WKTodd/AnaloguePPM/readme.md

Analogue Peak Meter using 101 segment Vacuum Flourescent Display module.

Uses a Microchip PIC 12F1572 (MPASM) and simple hardware
