WKTodd/AnaloguePPM/Hardware/VDF Meter Case base.STL

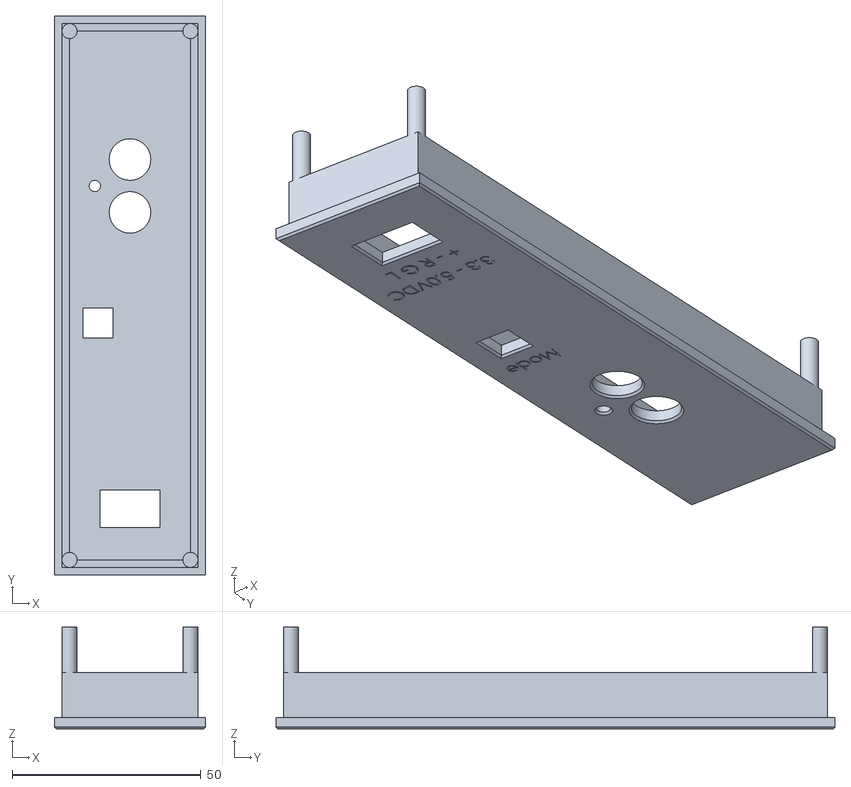
[picture p1: CAD file, 2021-10-20]
Hardware/VDF Meter Case base.STL
40.0 x 148.0 x 27.0
