WKTodd/AnaloguePPM/Hardware/VDF Meter Case.STL

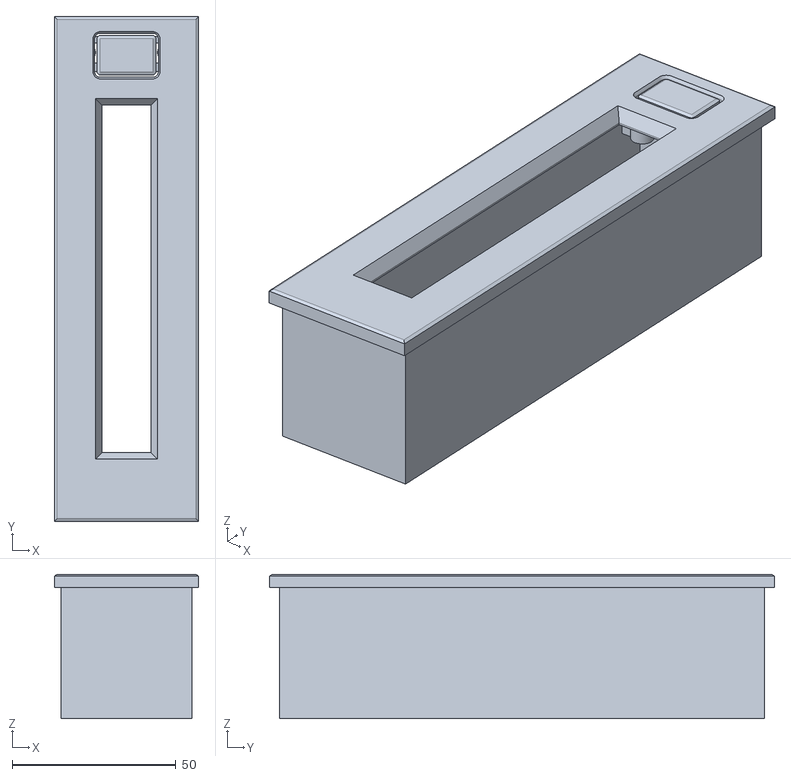
[picture p2: CAD file, 2021-10-20]
Hardware/VDF Meter Case.STL
44.0 x 154.0 x 44.0
