WKTodd/AnaloguePPM/ADT Analogue Peak Meter.pdf

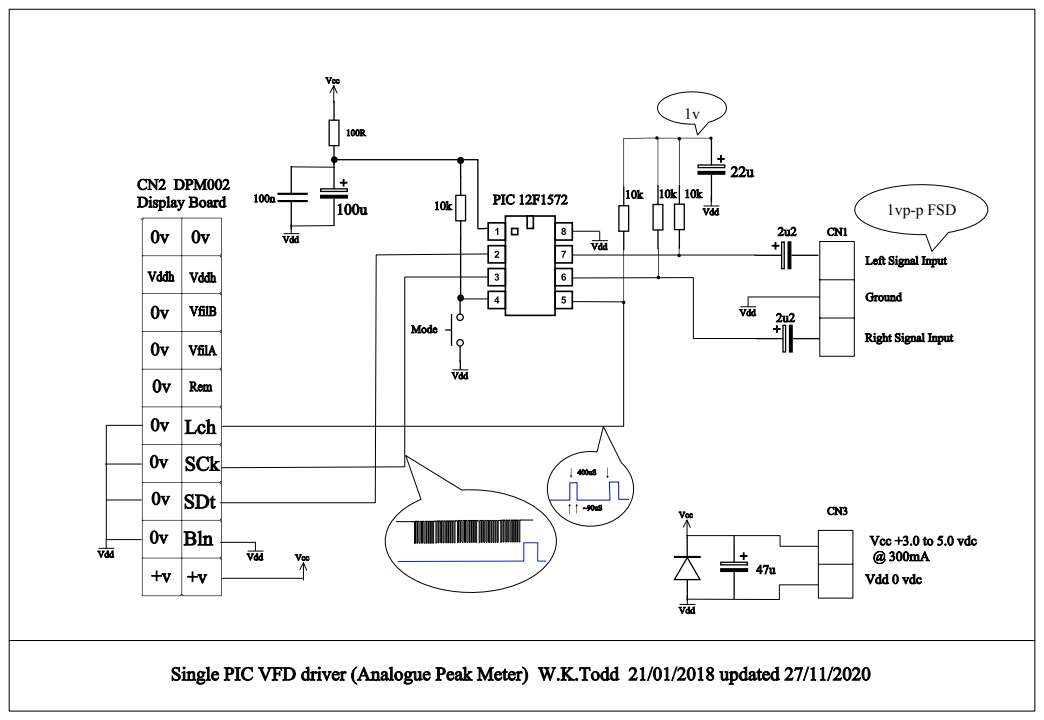
[picture p3: page 1]
Vdd; Vcc; PIC 12F1572; Ground; CN2 DPM002 Display Board; SDt; Bln; SCk; Lch; Mode; Vddh; VfilB; VfilA; Rem; 1vp-p FSD

Left Signal Input

Right Signal Input

Vcc +3.0 to 5.0 vdc
Vdd 0 vdc

Single PIC VFD driver (Analogue Peak Meter) W.K.Todd 21/01/2018 updated 27/11/2020

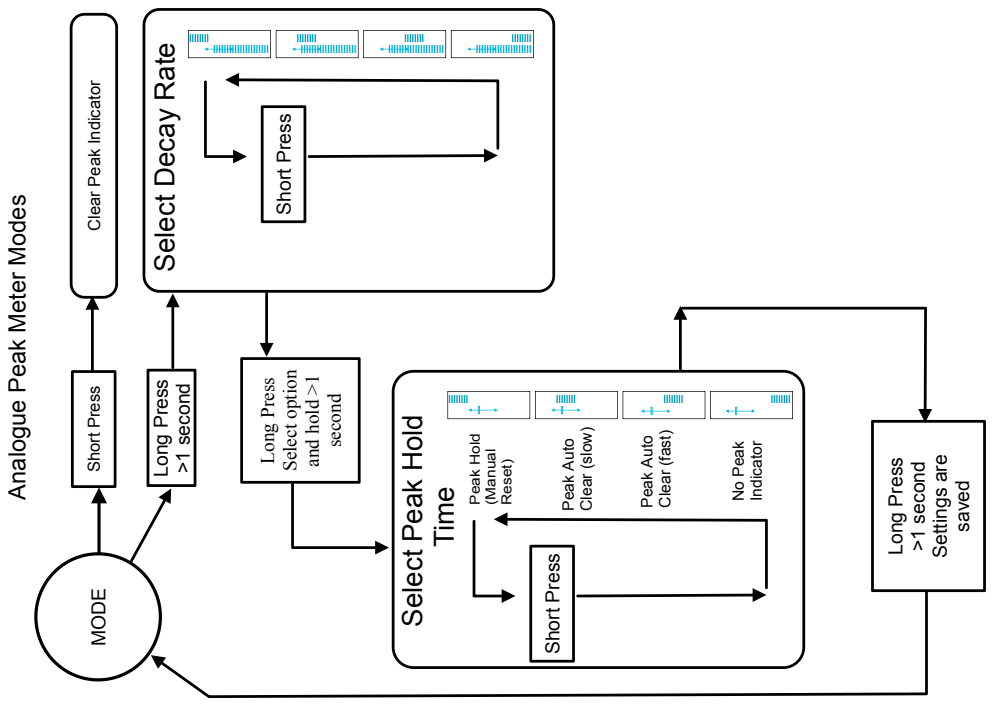
[picture p4: page 2]
Long Press; >1 second; Select option; and hold >1; second; Short Press; Time; No Peak; Indicator; Peak Auto; Clear (slow); Peak Hold; (Manual; Reset); Clear (fast); Settings are; saved

Select Decay Rate

Short Press Clear Peak Indicator MODE

Analogue Peak Meter Modes

Select Peak Hold
